Angieeeeeee/Senior-Design-Project-IBM-7535-Robotic-Arm/Datasheets/IBM7535OPTATB1RBypass.kicad_sch

## KiCad design Datasheets/IBM7535OPTATB1RBypass.kicad_sch (2025-08-06)

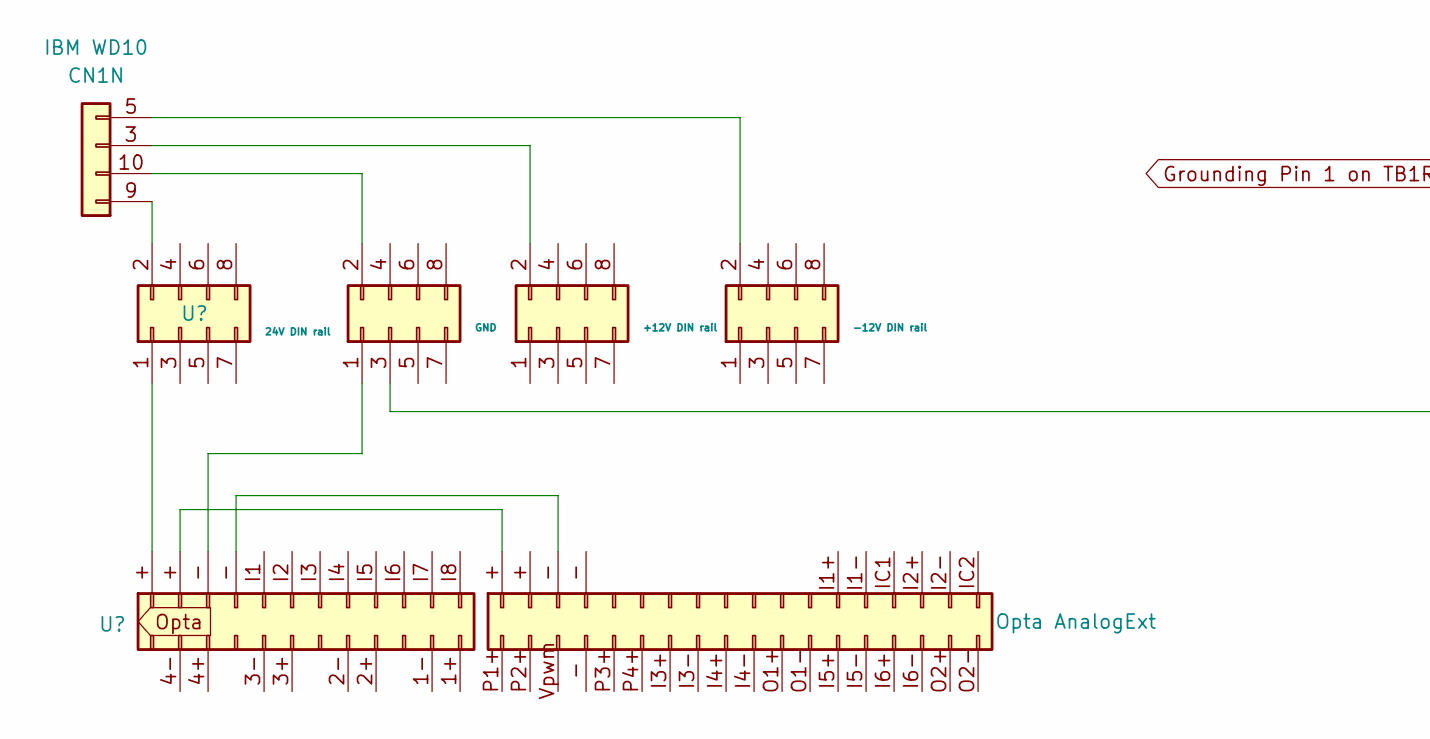
[picture p11: schematic IBM7535OPTATB1RBypass.kicad_sch, part in row 1, column 1]

Parts:
-12V: -12V DIN rail
IBM WD10: CN1N
Opta AnalogExt: (no value)
TB1R: (no value)

Connections:
unnamed: -12V.2, IBM WD10.5 (Pin_4)
