Angieeeeeee/Senior-Design-Project-IBM-7535-Robotic-Arm/Datasheets/IBM7535OPTATHETA1THETA2.kicad_sch

## KiCad design Datasheets/IBM7535OPTATHETA1THETA2.kicad_sch (2025-08-06)

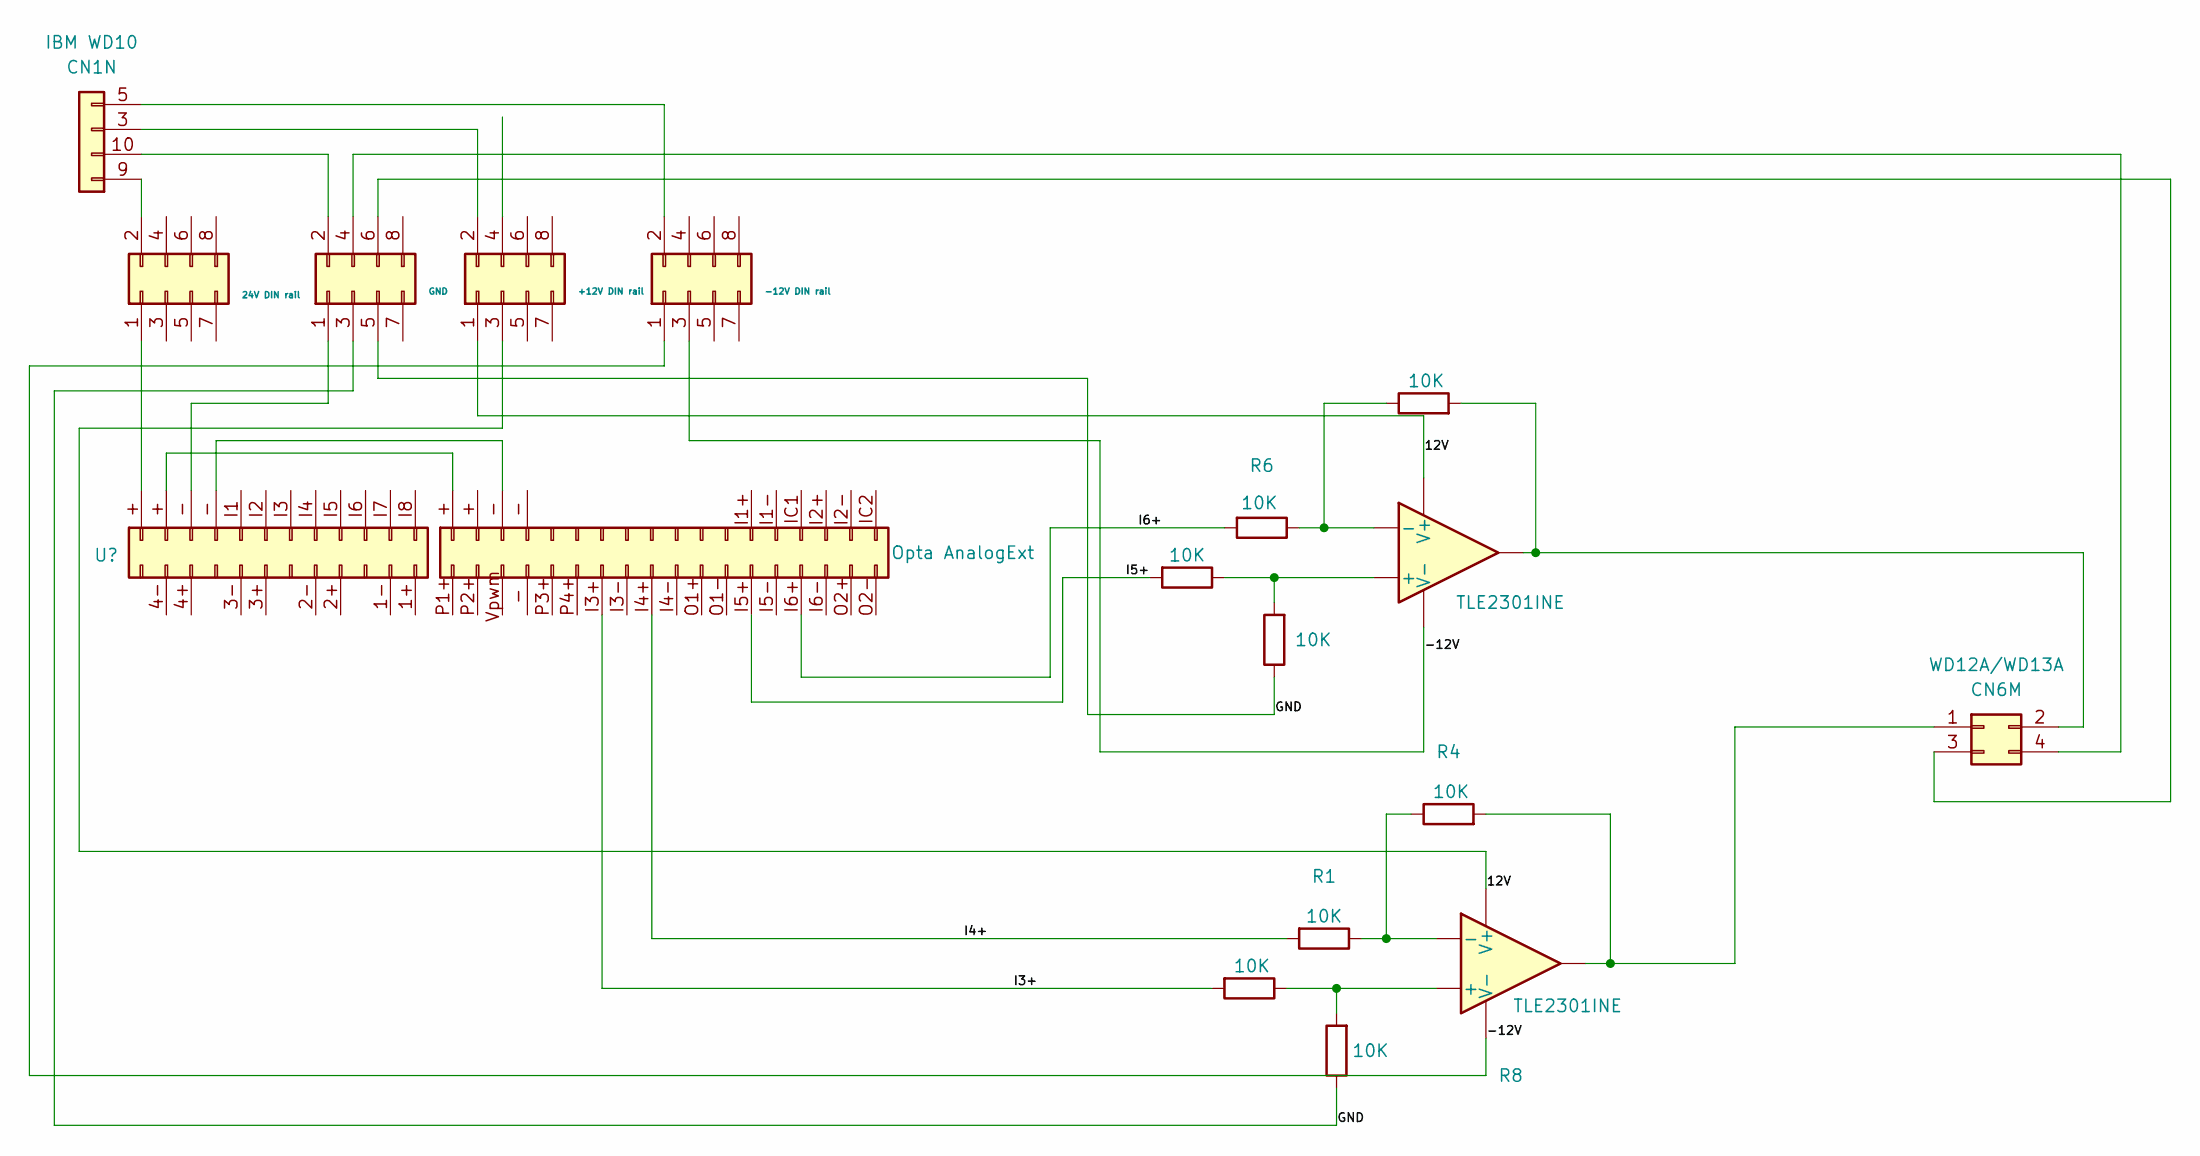
[picture p12: schematic IBM7535OPTATHETA1THETA2.kicad_sch]

Parts:
-12V: -12V DIN rail
IBM WD10: CN1N
Opta AnalogExt: (no value)
R1, R2, R3, R4, R5, R6, R7, R8: 10K
TLE2301INE: TSOT-23-5
WD12A/WD13A: CN6M

Connections:
12V: TLE2301INE.
-12V: -12V.1, -12V.3, TLE2301INE.
GND: R3.1, R7.1
I3+: Opta AnalogExt.I3+ (Pin_30), R2.2
I4+: Opta AnalogExt.I4+ (Pin_28), R1.2
I5+: Opta AnalogExt.I5+ (Pin_24), R5.2
I6+: Opta AnalogExt.I6+ (Pin_22), R6.2
unnamed: -12V.2, IBM WD10.5 (Pin_4)
unnamed: R1.1, R4.1, TLE2301INE.
unnamed: R2.1, R3.2, TLE2301INE.
unnamed: R4.2, TLE2301INE., WD12A/WD13A.1
unnamed: R5.1, R7.2, TLE2301INE.
unnamed: R6.1, R8.1, TLE2301INE.
unnamed: R8.2, TLE2301INE., WD12A/WD13A.2
