Angieeeeeee/Senior-Design-Project-IBM-7535-Robotic-Arm/Datasheets/IBM7535OPTATHETA1THETA2ENCOSTEPPERRAREARHOME.kicad_sch

## KiCad design Datasheets/IBM7535OPTATHETA1THETA2ENCOSTEPPERRAREARHOME.kicad_sch (2025-08-06)

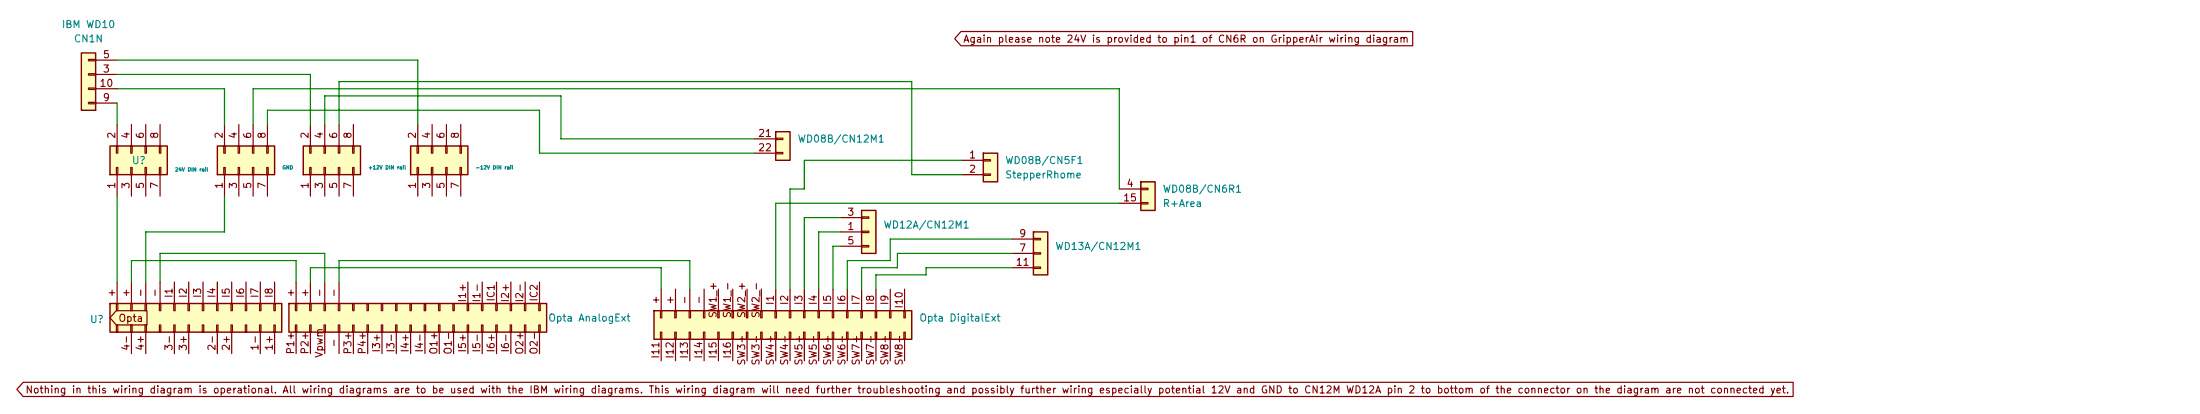
[picture p13: schematic IBM7535OPTATHETA1THETA2ENCOSTEPPERRAREARHOME.kicad_sch]

Parts:
-12V: -12V DIN rail
IBM WD10: CN1N
Opta AnalogExt: (no value)
Opta DigitalExt: (no value)
WD08B/CN5F1: StepperRhome
WD08B/CN6R1: R+Area
WD08B/CN12M1, WD12A/CN12M1, WD13A/CN12M1: (no value)

Connections:
unnamed: -12V.2, IBM WD10.5 (Pin_4)
unnamed: Opta AnalogExt.+ (Pin_1), Opta DigitalExt.+ (Pin_1)
unnamed: Opta AnalogExt.- (Pin_3), Opta DigitalExt.- (Pin_5)
unnamed: Opta DigitalExt.I1 (Pin_17), WD08B/CN6R1.15 (Pin_2)
unnamed: Opta DigitalExt.I2 (Pin_19), WD08B/CN5F1.1
unnamed: Opta DigitalExt.I3 (Pin_21), WD12A/CN12M1.3 (Pin_1)
unnamed: Opta DigitalExt.I4 (Pin_23), WD12A/CN12M1.1 (Pin_2)
unnamed: Opta DigitalExt.I5 (Pin_25), WD12A/CN12M1.5 (Pin_3)
unnamed: Opta DigitalExt.I6 (Pin_27), WD13A/CN12M1.9 (Pin_1)
unnamed: Opta DigitalExt.I7 (Pin_29), WD13A/CN12M1.7 (Pin_2)
unnamed: Opta DigitalExt.I8 (Pin_31), WD13A/CN12M1.11 (Pin_3)
