Angieeeeeee/Senior-Design-Project-IBM-7535-Robotic-Arm/Datasheets/IBM7535OPTATHETA1THETA2SENSORS.kicad_sch

## KiCad design Datasheets/IBM7535OPTATHETA1THETA2SENSORS.kicad_sch (2025-08-06)

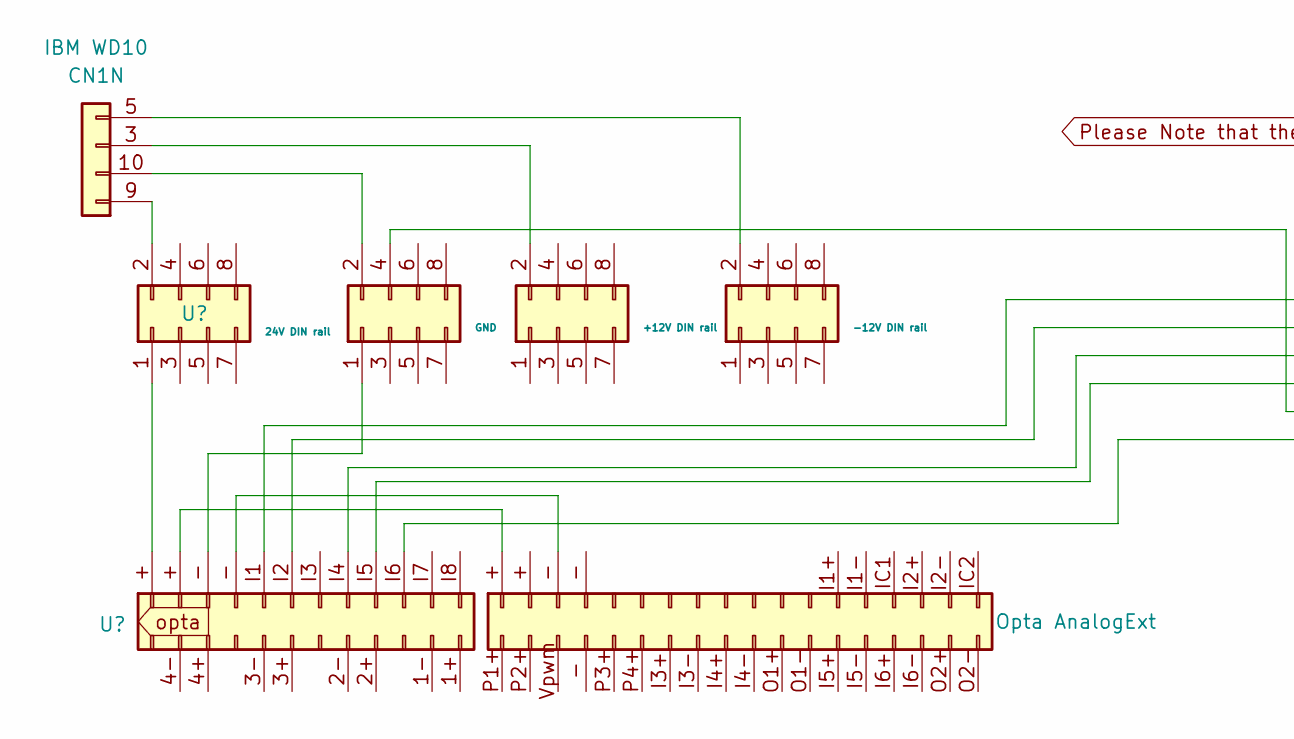
[picture p14: schematic IBM7535OPTATHETA1THETA2SENSORS.kicad_sch, part in row 1, column 1]

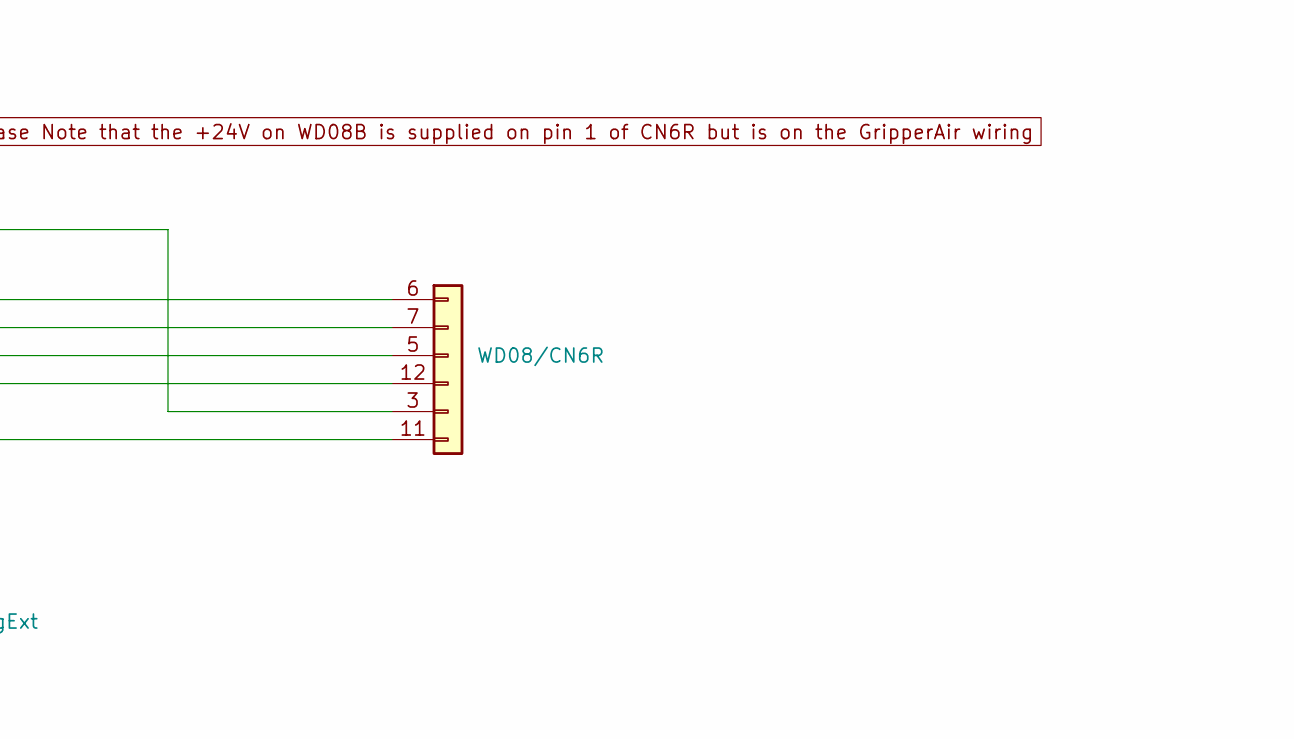
[picture p15: schematic IBM7535OPTATHETA1THETA2SENSORS.kicad_sch, part in row 1, column 2]

Parts:
-12V: -12V DIN rail
IBM WD10: CN1N
Opta AnalogExt: (no value)
WD08/CN6R: Conn_01x06

Connections:
unnamed: -12V.2, IBM WD10.5 (Pin_4)
