Angieeeeeee/Senior-Design-Project-IBM-7535-Robotic-Arm/Datasheets/IBM7535OPTAZDownGripperwithSensors.kicad_sch

## KiCad design Datasheets/IBM7535OPTAZDownGripperwithSensors.kicad_sch (2025-08-06)

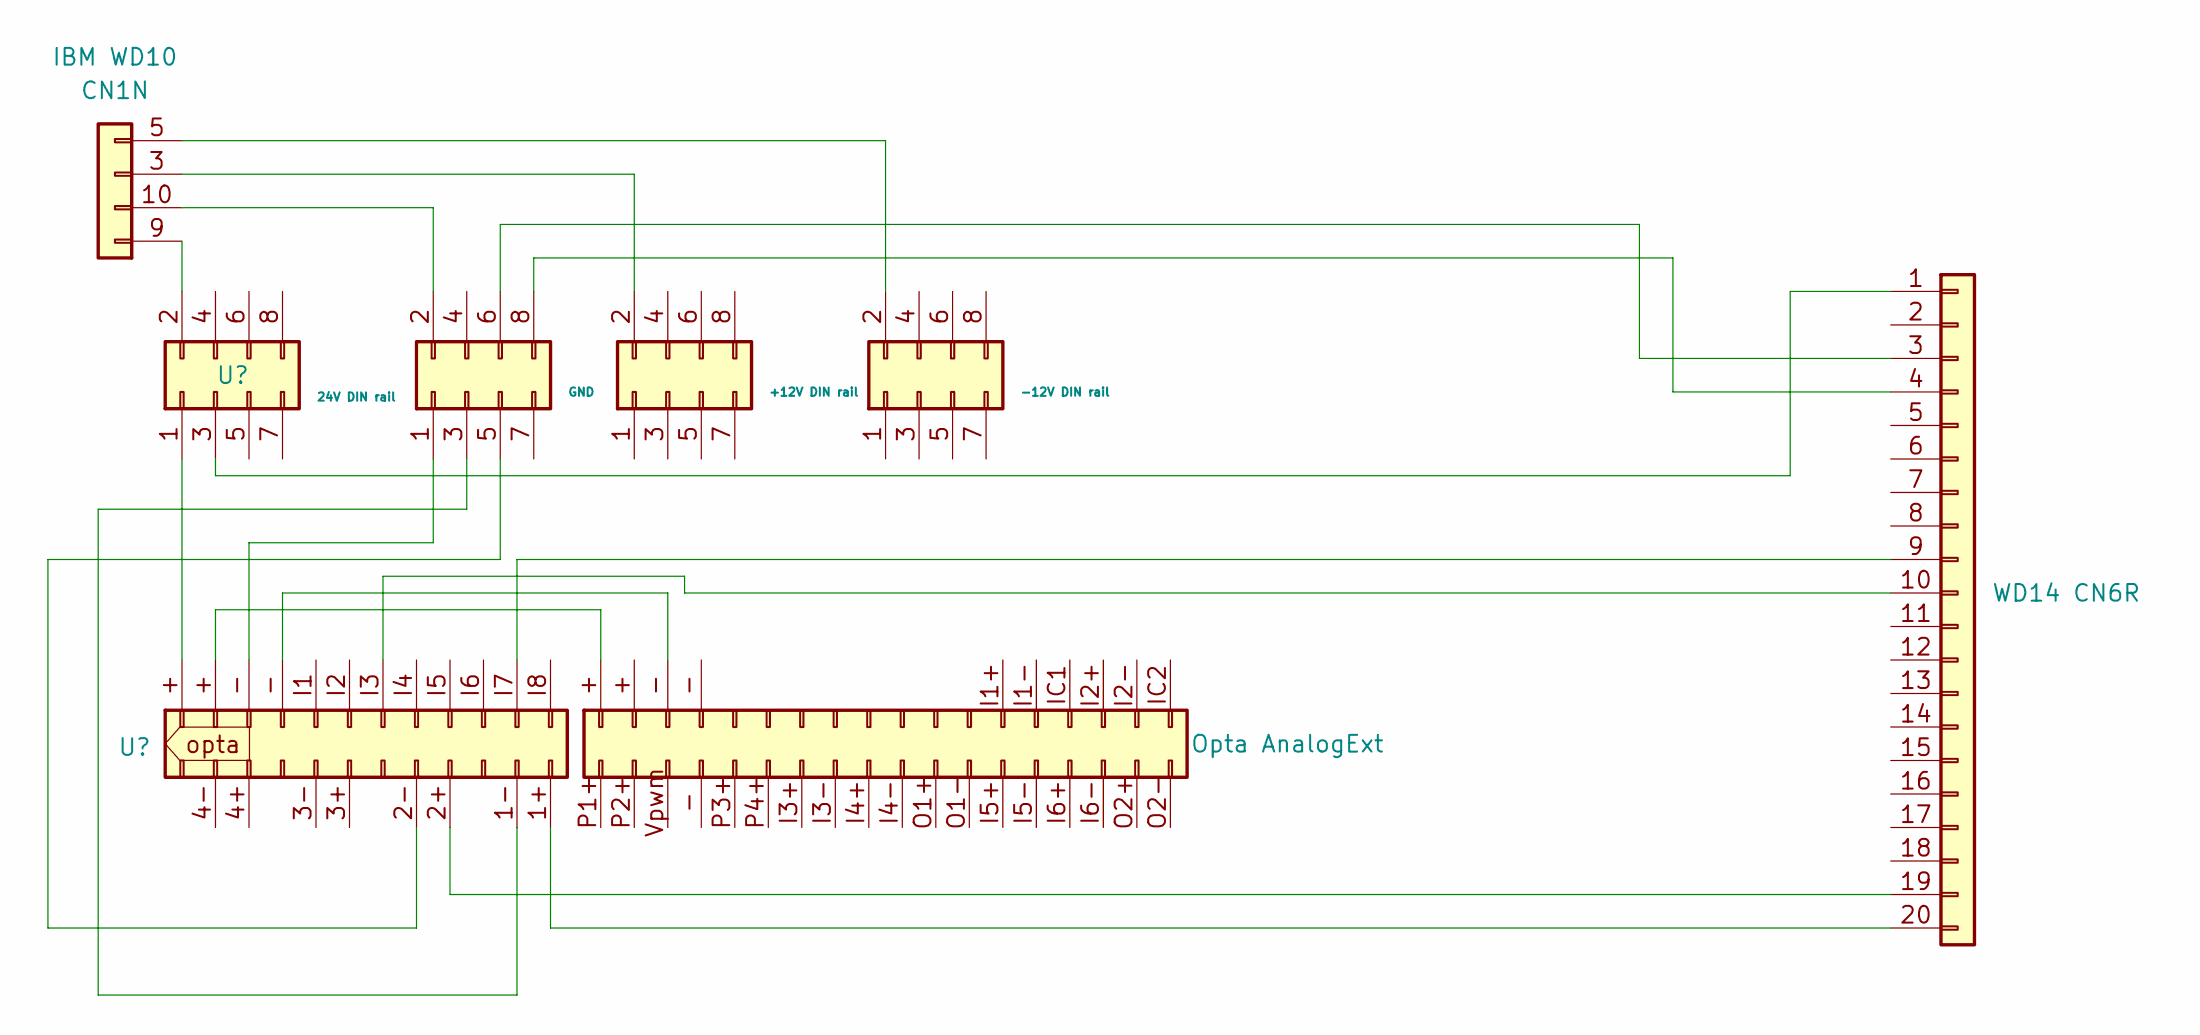
[picture p16: schematic IBM7535OPTAZDownGripperwithSensors.kicad_sch]

Parts:
-12V: -12V DIN rail
IBM WD10: CN1N
Opta AnalogExt: (no value)
WD14 CN6R: Conn_01x20

Connections:
unnamed: -12V.2, IBM WD10.5 (Pin_4)
