Angieeeeeee/Senior-Design-Project-IBM-7535-Robotic-Arm/(commit log)

2025-02-20 added 2 documents relating to AML and the arm
2025-08-06 Add files via upload
    Wiring diagram to be used in conjunction with IBM wiring diagram.
    [IBM7535OPTATHETA1THETA2.kicad_sch]
2025-08-06 Wiring Diagram to be used in conjunction with IBM wiring diagrams.
    [IBM7535OPTATHETA1THETA2.kicad_sch]
2025-08-06 This test exercises the Theta1 motor with use of the sensor.
2025-08-06 Working Theta2 Test with sensor detection
2025-08-06 Working Gripper and Air test with postion detection.
2025-08-06 Will operate stepper motor and stop.
2025-08-07 OpAmp and Voltage divider layout.
